aspyra/turboino_nano/README.md

# turboino_nano
SAMC21E development board compatible with Arduino Nano
