aspyra/turboino_nano/nano_samc21e.kicad_pcb

## KiCad design nano_samc21e.kicad_pcb (2022-05-03)

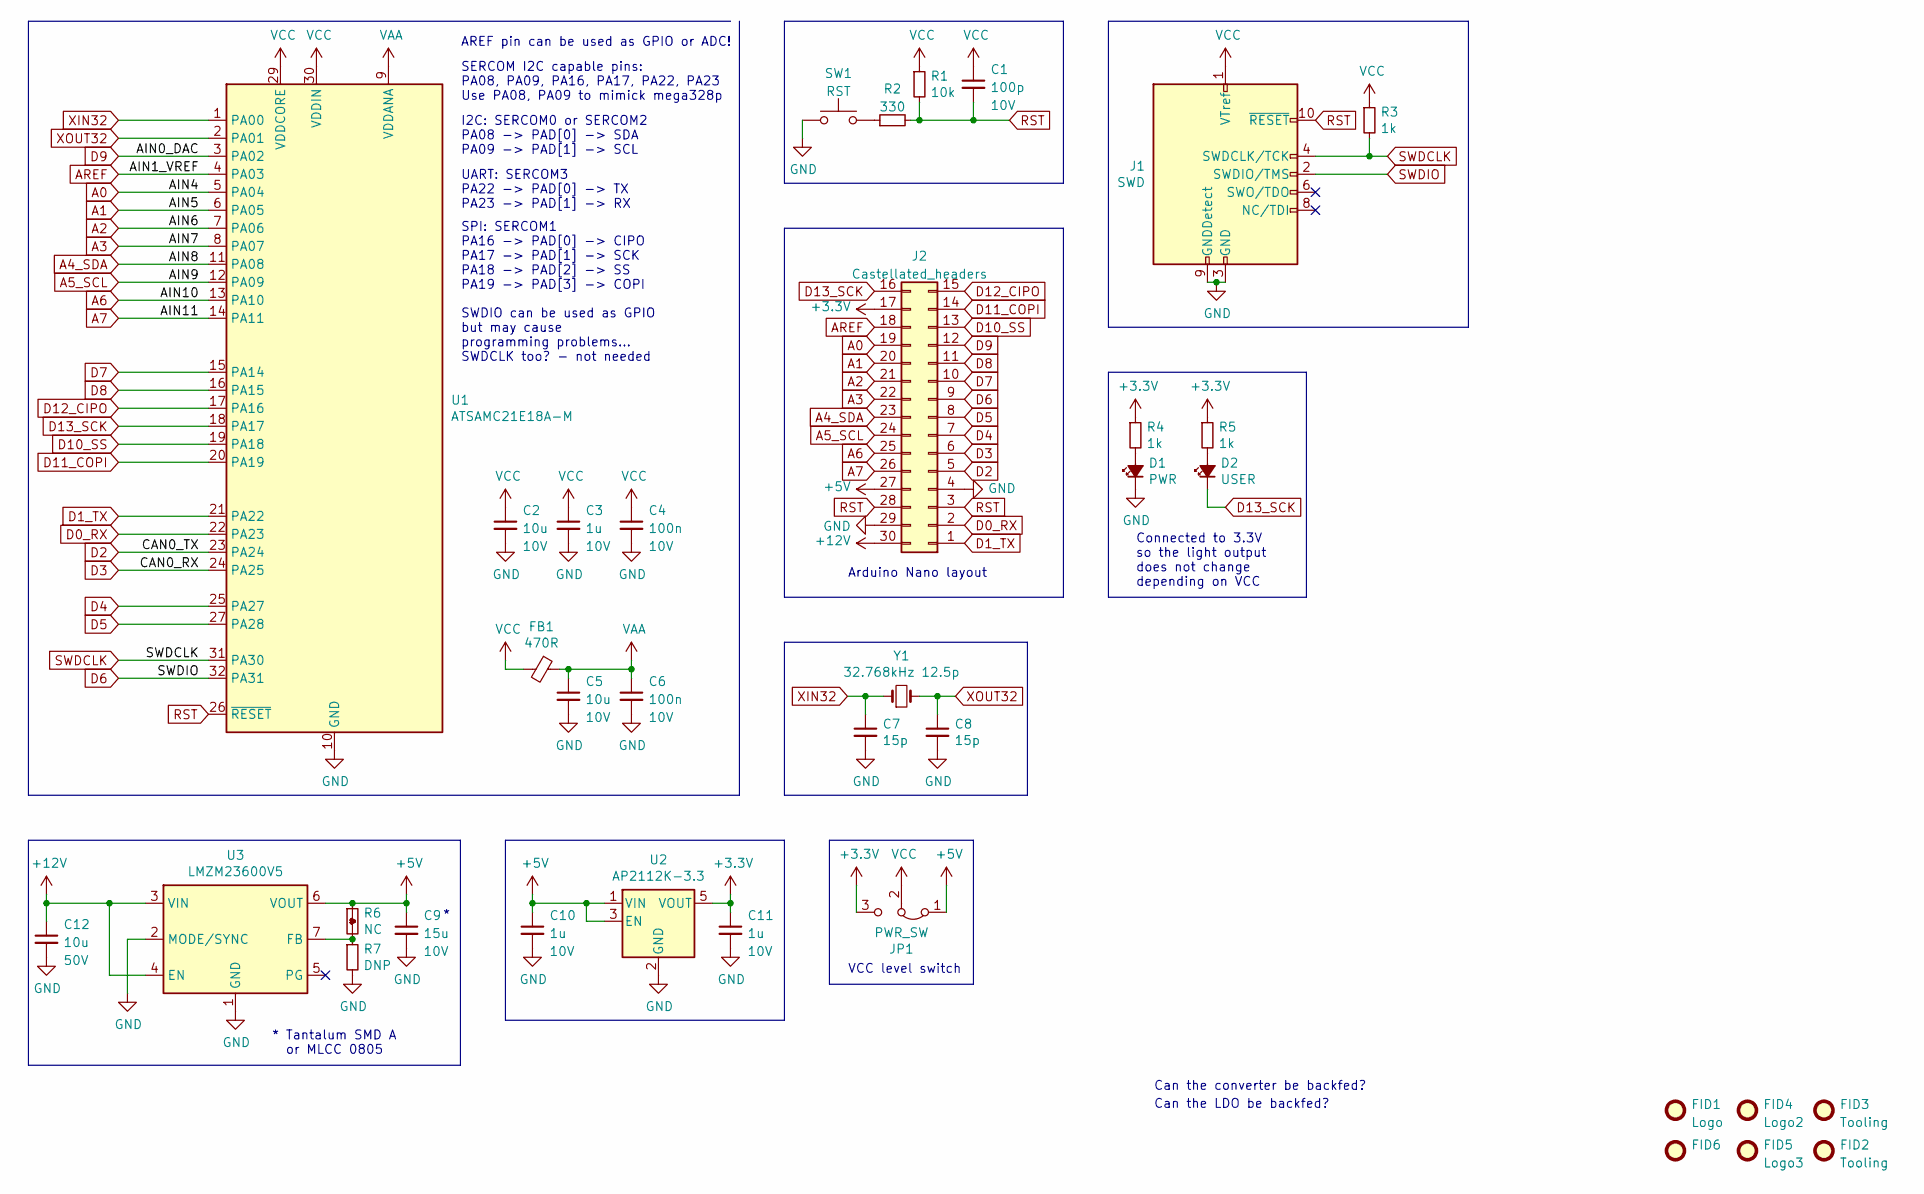
[picture p1: schematic nano_samc21e.kicad_sch]

Parts:
C1: 100p; 0402_minimalist; Rating 10V
C2, C5: 10u; 0603_minimalist; Rating 10V
C3, C10, C11: 1u; 0402_minimalist; Rating 10V
C4, C6: 100n; 0402_minimalist; Rating 10V
C7, C8: 15p; 0402_minimalist
C9: 15u; C_1206_3216Metric; Rating 10V
C12: 10u; C_1210_3225Metric; Rating 50V
D1: PWR; LED_0603_1608Metric
D2: USER; LED_0603_1608Metric
FB1: 470R; 0603_minimalist
FID1: Logo
FID2, FID3: Tooling; JLCPCB_tooling_hole
FID4: Logo2; turboino_logo
FID5: Logo3; turboino_back
FID6: (no value)
J1: SWD; PinHeader_2x05_P1.27mm_Vertical_SMD
J2: Castellated_headers; Arduino_Nano
JP1: PWR_SW; PinHeader_1x03_P2.54mm_Vertical
R1: 10k; 0402_minimalist
R2: 330; 0402_minimalist
R3, R4, R5: 1k; 0402_minimalist
R6: NC; 0402_NC_minimalist
R7: DNP; 0402_minimalist
SW1: RST; SW_SPST_SKQG_WithStem
U1: ATSAMC21E18A-M; QFN-32-1EP_5x5mm_P0.5mm_EP3.6x3.6mm
U2: AP2112K-3.3; SOT-23-5
U3: LMZM23600V5; LMZM2360X
Y1: 32.768kHz 12.5p; Crystal_SMD_3215-2Pin_3.2x1.5mm

Connections:
+3V3: C11.1, J2.17, JP1.3 (B), R4.1, R5.1, U2.5 (VOUT)
+5V: C9.1, C10.1, J2.27, JP1.1 (A), R6.1, U2.1 (VIN), U2.3 (EN), U3.6 (VOUT)
+12V: C12.1, J2.30, U3.3 (VIN), U3.4 (EN)
A0: J2.19, U1.5 (PA04)
A1: J2.20, U1.6 (PA05)
A2: J2.21, U1.7 (PA06)
A3: J2.22, U1.8 (PA07)
A4_SDA: J2.23, U1.11 (PA08)
A5_SCL: J2.24, U1.12 (PA09)
A6: J2.25, U1.13 (PA10)
A7: J2.26, U1.14 (PA11)
AREF: J2.18, U1.4 (PA03)
D0_RX: J2.2, U1.22 (PA23)
D1_TX: J2.1, U1.21 (PA22)
D2: J2.5, U1.23 (PA24)
D3: J2.6, U1.24 (PA25)
D4: J2.7, U1.25 (PA27)
D5: J2.8, U1.27 (PA28)
D6: J1.2 (SWDIO/TMS), J2.9, U1.32 (PA31)
D7: J2.10, U1.15 (PA14)
D8: J2.11, U1.16 (PA15)
D9: J2.12, U1.3 (PA02)
D10_SS: J2.13, U1.19 (PA18)
D11_COPI: J2.14, U1.20 (PA19)
D12_CIPO: J2.15, U1.17 (PA16)
D13_SCK: D2.1 (K), J2.16, U1.18 (PA17)
GND: C2.2, C3.2, C4.2, C5.2, C6.2, C7.2, C8.2, C9.2, C10.2, C11.2, C12.2, D1.1 (K), J1.3 (GND), J1.5 (GND), J1.9 (GNDDetect), J2.4, J2.29, R7.2, SW1.1, U1.10 (GND), U1.28 (GND), U2.2 (GND), U3.1 (GND), U3.2 (MODE/SYNC), U3.11 (GND)
unnamed: D1.2 (A), R4.2
unnamed: D2.2 (A), R5.2
unnamed: R2.1, SW1.2
unnamed: R6.2, R7.1, U3.7 (FB)
RST: C1.2, J1.10 (~RESET), J2.3, J2.28, R1.2, R2.2, U1.26 (~RESET)
SWDCLK: J1.4 (SWDCLK/TCK), R3.2, U1.31 (PA30)
VAA: C5.1, C6.1, FB1.1, U1.9 (VDDANA)
VCC: C1.1, C2.1, C3.1, C4.1, FB1.2, J1.1 (VTref), JP1.2 (C), R1.1, R3.1, U1.29 (VDDCORE), U1.30 (VDDIN)
XIN32: C7.1, U1.1 (PA00), Y1.1
XOUT32: C8.1, U1.2 (PA01), Y1.2

Notes on the sheet:
VCC level switch
UART: SERCOM3 PA22 -> PAD[0] -> TX PA23 -> PAD[1] -> RX
SPI: SERCOM1 PA16 -> PAD[0] -> CIPO PA17 -> PAD[1] -> SCK PA18 -> PAD[2] -> SS PA19 -> PAD[3] -> COPI
I2C: SERCOM0 or SERCOM2 PA08 -> PAD[0] -> SDA PA09 -> PAD[1] -> SCL
Arduino Nano layout
AREF pin can be used as GPIO or ADC!
SERCOM I2C capable pins: PA08, PA09, PA16, PA17, PA22, PA23 Use PA08, PA09 to mimick mega328p
* Tantalum SMD A or MLCC 0805
SWDIO can be used as GPIO but may cause programming problems... SWDCLK too? - not needed
Connected to 3.3V so the light output does not change depending on VCC
Can the converter be backfed?
Can the LDO be backfed?

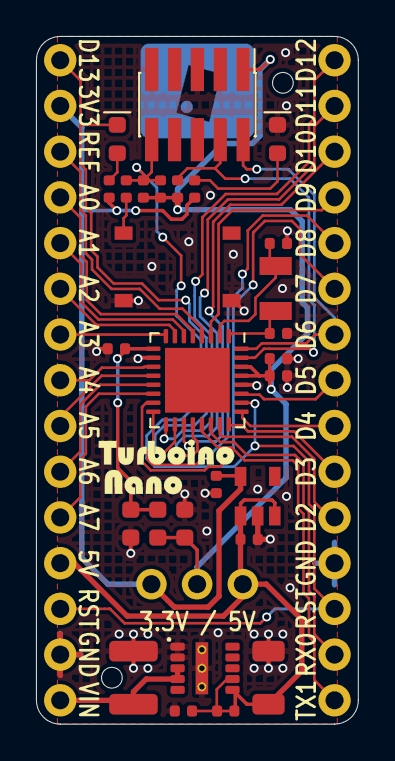
[picture p2: board nano_samc21e.kicad_pcb from above]

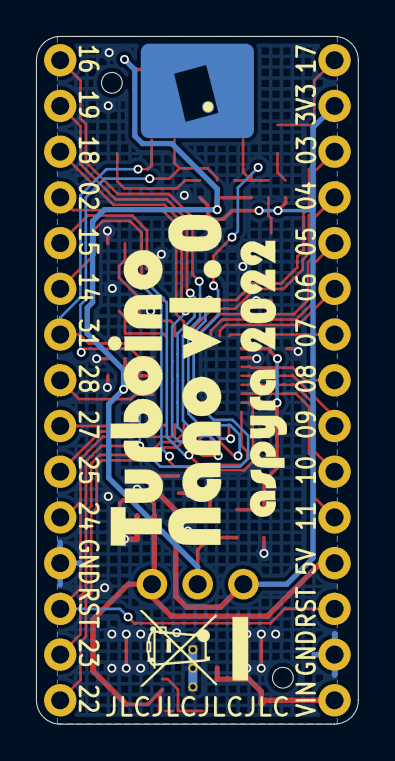
[picture p3: board nano_samc21e.kicad_pcb from below]

Board: 2 copper layers, 17.9 x 38.2 mm, 36 parts (3 on the bottom side), 37 nets.
