aspyra/turboino_nano/(commit log)

2022-04-27 First commit - schematic more or less done, starting 4 layer layout
    [nano_samc21e.kicad_pcb, nano_samc21e.kicad_sch]
2022-05-02 Massive rework: - 2 layer PCB - design restraints set according to JLCPCB capabilites - no castellated holes, smaller board dimensions - Arduino style numbering on top silkscreen - Changed footprints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
    [nano_samc21e.kicad_pcb, nano_samc21e.kicad_sch]
2022-05-03 v1.0 finished - layout and routing finished - added front and back graphics, JLCPCB tooling holes
    [nano_samc21e.kicad_pcb, nano_samc21e.kicad_sch]
2022-05-03 Generated JLCPCB output files
    [BOM-nano_samc21e.csv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]
2022-05-03 Added missing pin numbering Added WEEE logo Added JLCPCB order number Generated fresh JLCPCB output files
    [BOM-nano_samc21e.csv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]
